Audio-Rochey/TerrainTronics-CilgerranCastle/CilgerranPG2p0Schematic.jpg

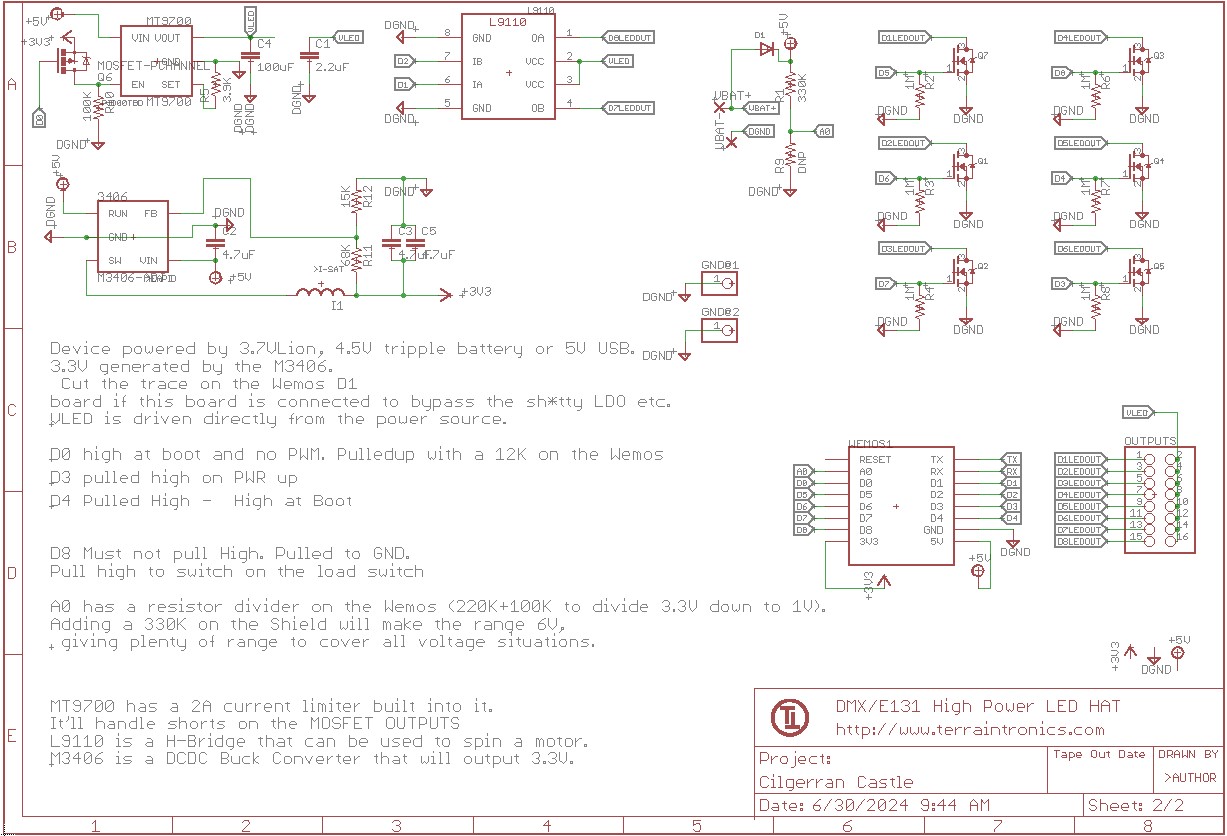
CilgerranPG2p0Schematic.jpg
