Audio-Rochey/TerrainTronics-CilgerranCastle/(commit log)

2024-08-18 Initial upload
    Basic Gravestone / Motor / Solenoid Wobble.
    [Cilgerran2-Gravestone.ino]
2025-05-05 working code
    IP address can accept OTA updates on port :81/updates.
    This code also makes the device visible in WindowsExplorer under Network.
